ik5pwc/12v-ups/Kicad/monitoring/monitoring.kicad_pcb

## KiCad design Kicad/monitoring/monitoring.kicad_pcb (2025-08-01)

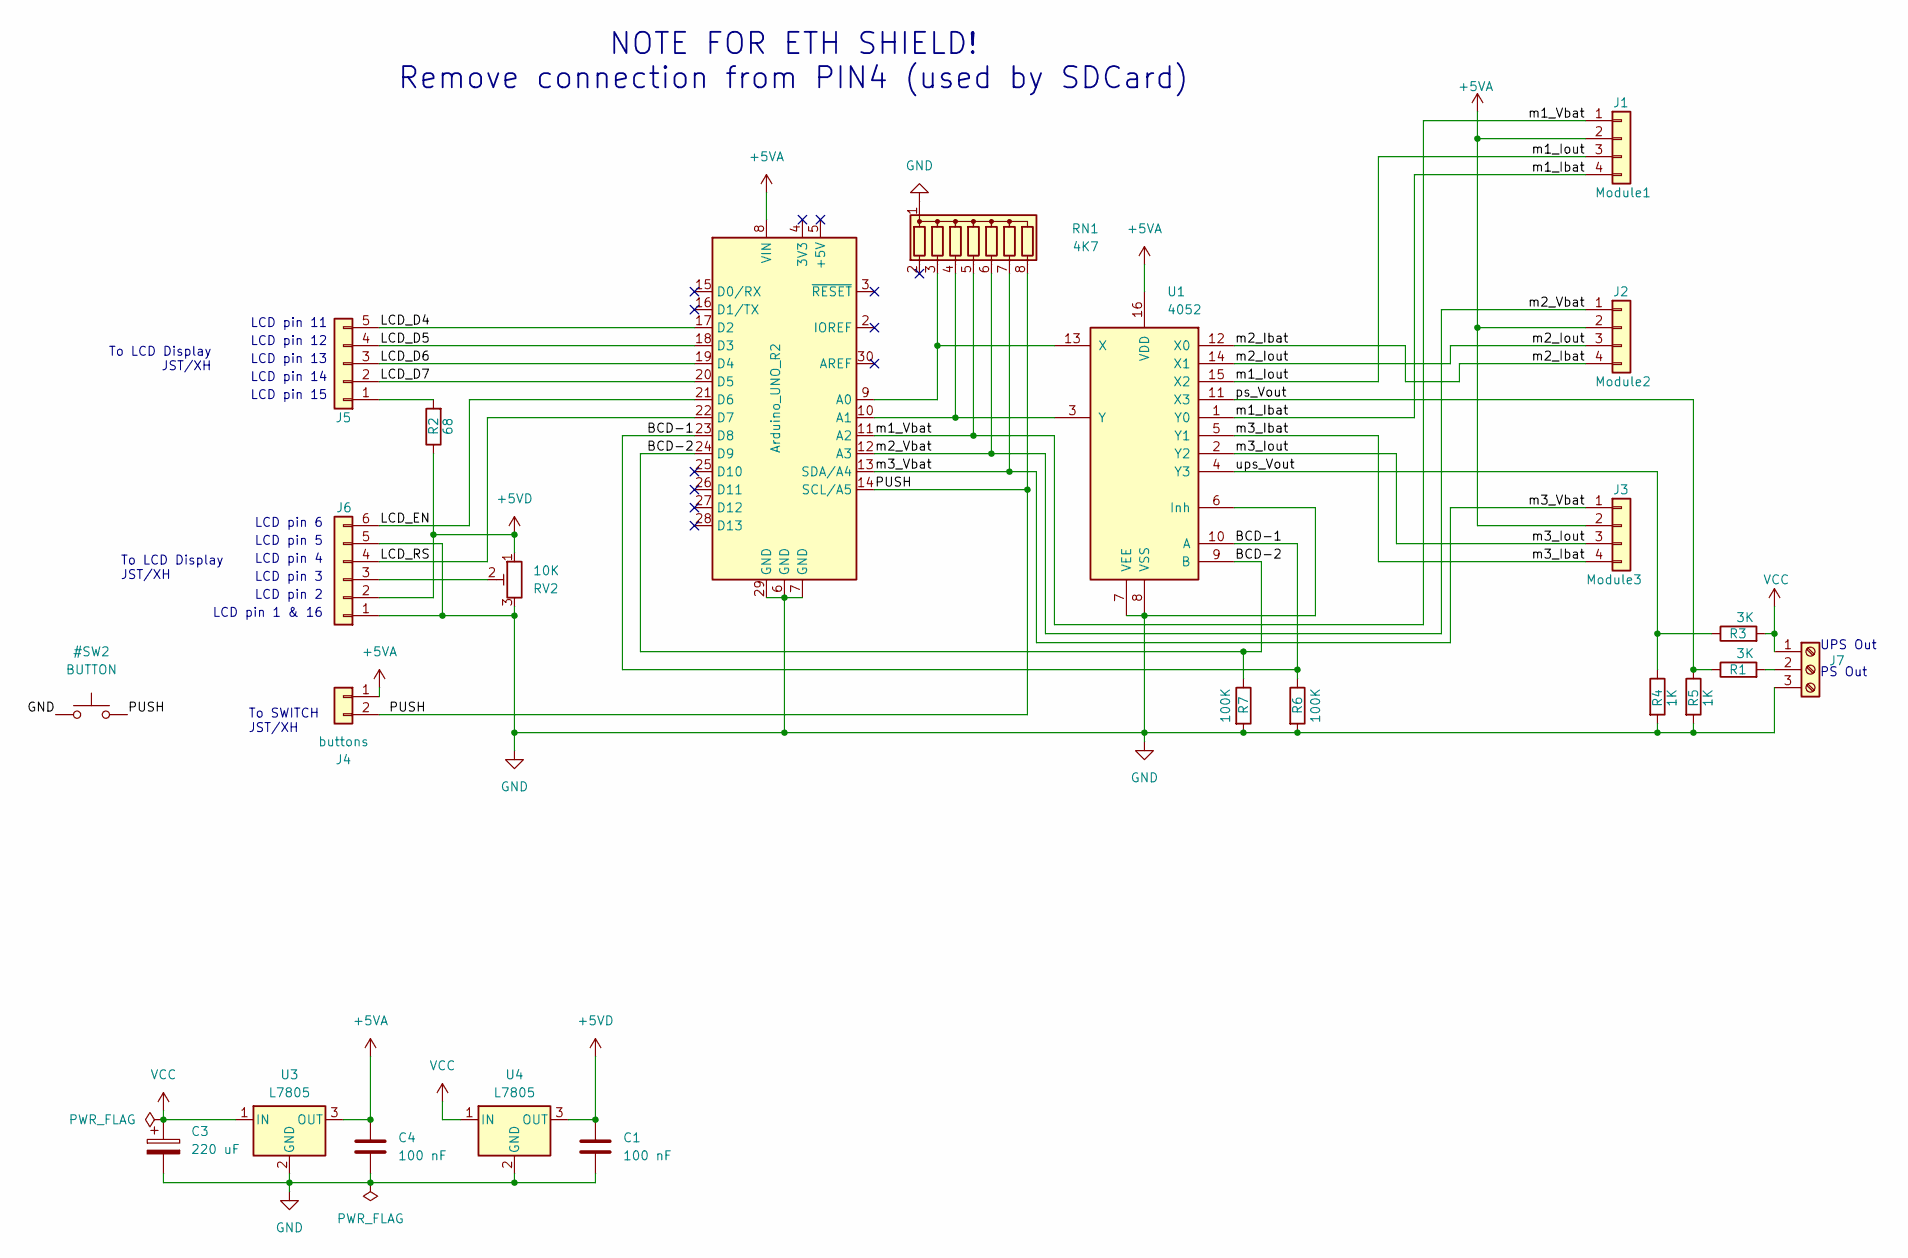
[picture p1: schematic monitoring.kicad_sch]

Parts:
A1: Arduino_UNO_R2
C1, C4: 100 nF; C_Disc_D4.7mm_W2.5mm_P5.00mm
C3: 220 uF; CP_Radial_D10.0mm_P5.00mm
J1: Module1; JST_XH_B4B-XH-A_1x04_P2.50mm_Vertical
J2: Module2; JST_XH_B4B-XH-A_1x04_P2.50mm_Vertical
J3: Module3; JST_XH_B4B-XH-A_1x04_P2.50mm_Vertical
J4: buttons; JST_XH_B2B-XH-A_1x02_P2.50mm_Vertical
J5: Display; JST_XH_B5B-XH-A_1x05_P2.50mm_Vertical
J6: Display; JST_XH_B6B-XH-A_1x06_P2.50mm_Vertical
J7: DC_in_outout; TerminalBlock_bornier-3_P5.08mm
R1, R3: 3K; R_Axial_DIN0204_L3.6mm_D1.6mm_P7.62mm_Horizontal
R2: 68; R_Axial_DIN0204_L3.6mm_D1.6mm_P7.62mm_Horizontal
R4, R5: 1K; R_Axial_DIN0204_L3.6mm_D1.6mm_P7.62mm_Horizontal
R6, R7: 100K; R_Axial_DIN0204_L3.6mm_D1.6mm_P7.62mm_Horizontal
RN1: 4K7; R_Array_SIP8
RV2: 10K; Potentiometer_Bourns_3296W_Vertical
U1: 4052; DIP-16_W7.62mm_LongPads
U3, U4: L7805; TO-220-3_Vertical

Connections:
+5VA: A1.8 (VIN), C4.1, J1.2, J2.2, J3.2, J4.1, U1.16 (VDD), U3.3 (OUT)
+5VD: C1.1, J6.2, R2.1, RV2.1, U4.3 (OUT)
/BCD-1: A1.23 (D8), R6.1, U1.10 (A)
/BCD-2: A1.24 (D9), R7.1, U1.9 (B)
/LCD_D4: A1.17 (D2), J5.5
/LCD_D5: A1.18 (D3), J5.4
/LCD_D6: A1.19 (D4), J5.3
/LCD_D7: A1.20 (D5), J5.2
/LCD_EN: A1.21 (D6), J6.6
/LCD_RS: A1.22 (D7), J6.4
/PUSH: A1.14 (SCL/A5), J4.2, RN1.8 (R7)
/m1_Ibat: J1.4, U1.1 (Y0)
/m1_Iout: J1.3, U1.15 (X2)
/m1_Vbat: A1.11 (A2), J1.1, RN1.5 (R4)
/m2_Ibat: J2.4, U1.12 (X0)
/m2_Iout: J2.3, U1.14 (X1)
/m2_Vbat: A1.12 (A3), J2.1, RN1.6 (R5)
/m3_Ibat: J3.4, U1.5 (Y1)
/m3_Iout: J3.3, U1.2 (Y2)
/m3_Vbat: A1.13 (SDA/A4), J3.1, RN1.7 (R6)
/ps_Vout: R1.1, R5.1, U1.11 (X3)
/ups_Vout: R3.1, R4.1, U1.4 (Y3)
GND: A1.6 (GND), A1.7 (GND), A1.29 (GND), C1.2, C3.2, C4.2, J6.1, J6.5, J7.3, R4.2, R5.2, R6.2, R7.2, RN1.1 (common), RV2.3, U1.6 (Inh), U1.7 (VEE), U1.8 (VSS), U3.2 (GND), U4.2 (GND)
unnamed: A1.9 (A0), RN1.3 (R2), U1.13 (X)
unnamed: A1.10 (A1), RN1.4 (R3), U1.3 (Y)
unnamed: J5.1, R2.2
unnamed: J6.3, RV2.2
unnamed: J7.2, R1.2
VCC: C3.1, J7.1, R3.2, U3.1 (IN), U4.1 (IN)

Notes on the sheet:
LCD pin 13
LCD pin 3
UPS Out
NOTE FOR ETH SHIELD! Remove connection from PIN4 (used by SDCard)
LCD pin 11
LCD pin 15
To SWITCH JST/XH
LCD pin 14
To LCD Display JST/XH
LCD pin 1 & 16
LCD pin 12
LCD pin 5
LCD pin 4
LCD pin 6
LCD pin 2
PS Out

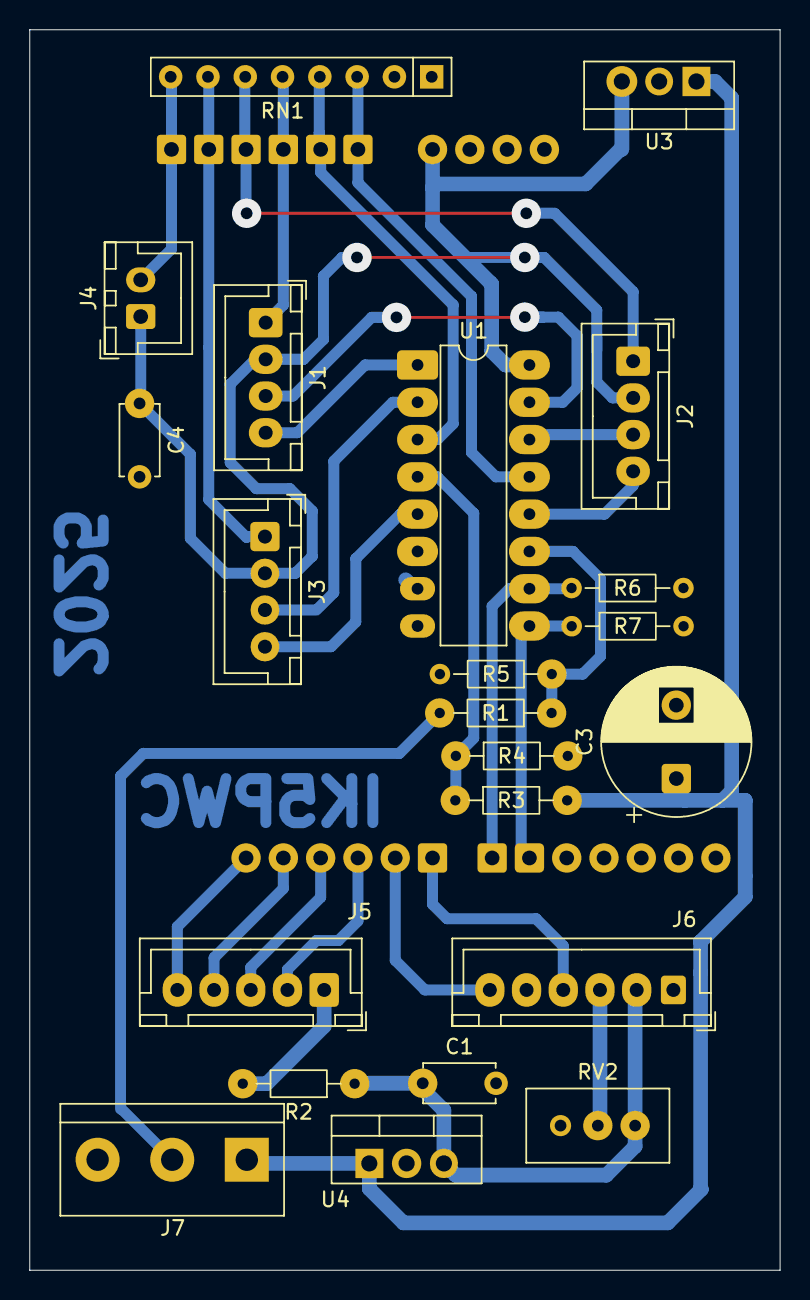
[picture p2: board monitoring.kicad_pcb from above]

Board: 2 copper layers, 51.1 x 84.5 mm, 23 parts (1 on the bottom side), 29 nets.
