ik5pwc/12v-ups/Kicad/12vUPS-modules-diodeIdeal-with-GND/12vUPS.kicad_pcb

## KiCad design Kicad/12vUPS-modules-diodeIdeal-with-GND/12vUPS.kicad_pcb (2025-06-20)

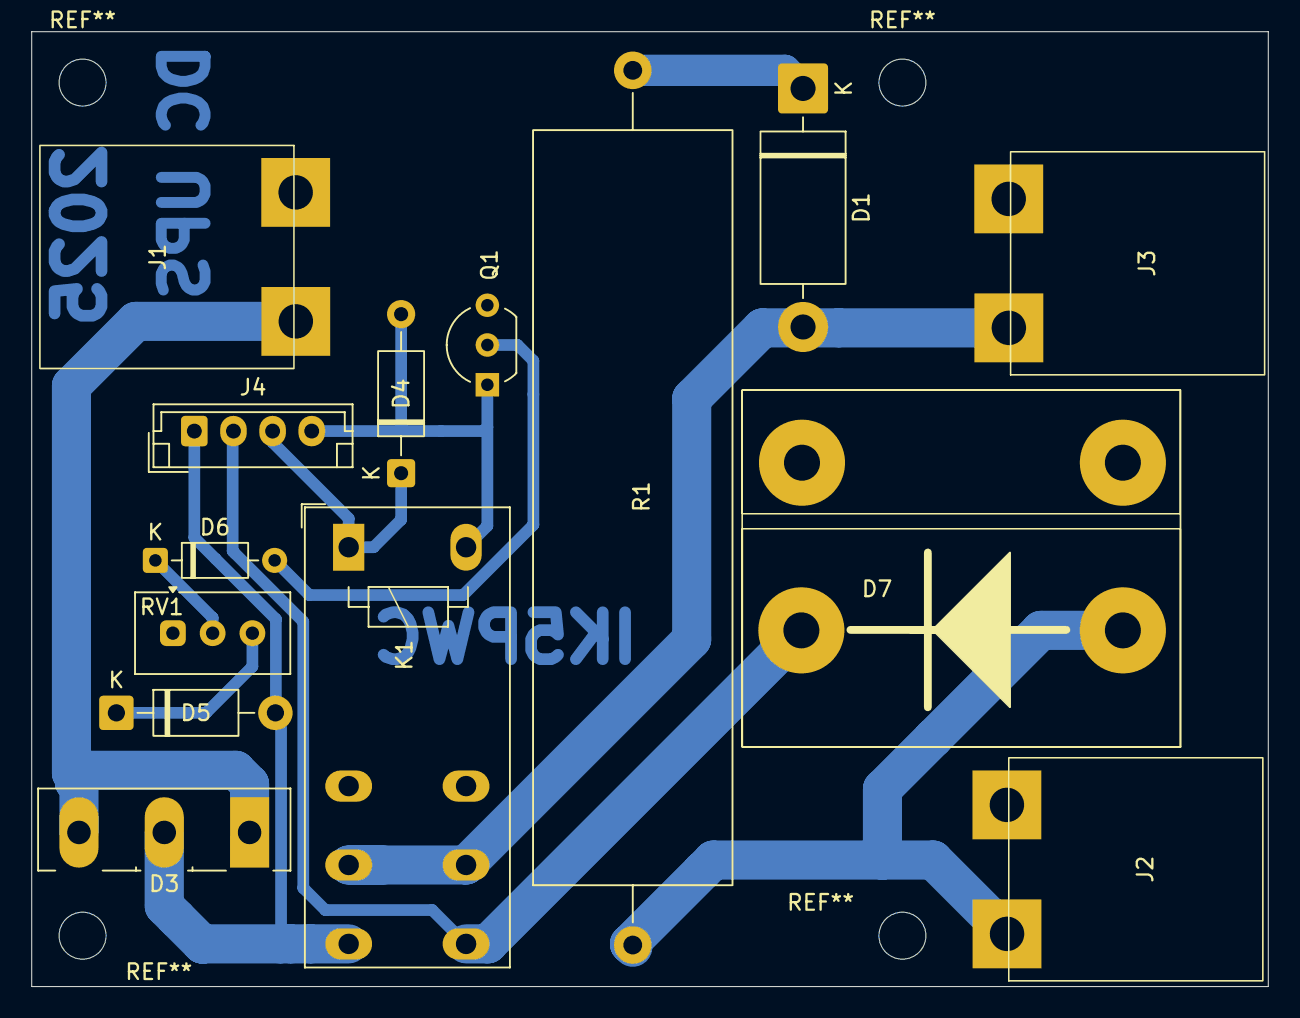
[picture p3: board 12vUPS.kicad_pcb from above]

Board: 2 copper layers, 79.0 x 61.0 mm, 14 parts (0 on the bottom side), 12 nets.

Parts:
D1: SF30GG; D_DO-201AD_P15.24mm_Horizontal
D3: 60CPQ150; TO-247-3_Vertical
D4: 1N4001; D_A-405_P10.16mm_Horizontal
D5: D; D_DO-41_SOD81_P10.16mm_Horizontal
D6: 4V1; D_DO-35_SOD27_P7.62mm_Horizontal
D7: D_Ideal; D_IDEAL_with_GND
J1: INPUT; Mammooth_4mm
J2: BATTERY; Mammooth_4mm
J3: OUTPUT; Mammooth_4mm
J4: ENABLE; JST_EH_B4B-EH-A_1x04_P2.50mm_Vertical
K1: VEGHA L08A0212VDC; VEGhA L08 12V dc
Q1: BC337; TO-92_Inline_Wide
R1: 2R7; R_Axial_Power_L48.0mm_W12.5mm_P55.88mm
RV1: 10K; Potentiometer_Vishay_T93YA_Vertical

Connections:
/BATT_IN: D7.2 (A), J2.1, R1.1
/BJT-GND: D4.2 (A), J4.4, K1.A2, Q1.1 (C)
/DC-IN-RELE: D3.2 (K), D5.2 (A), J4.1, K1.14
/DC_IN: D3.1 (A), D3.3 (A), J1.2
/ENA: D4.1 (K), J4.3, K1.A1
/OUT: D1.2 (A), J3.1, K1.11, K1.21
GND: D7.3 (GND), J1.1, J2.2, J3.2, Q1.3 (E), RV1.1
unnamed: D1.1 (K), R1.2
unnamed: D5.1 (K), RV1.3
unnamed: D6.2 (A), Q1.2 (B)
unnamed: D6.1 (K), RV1.2
unnamed: D7.1 (K), J4.2, K1.24
