ik5pwc/12v-ups/Kicad/SensorBoard/SensorBoard.kicad_pcb

## KiCad design Kicad/SensorBoard/SensorBoard.kicad_pcb (2025-07-25)

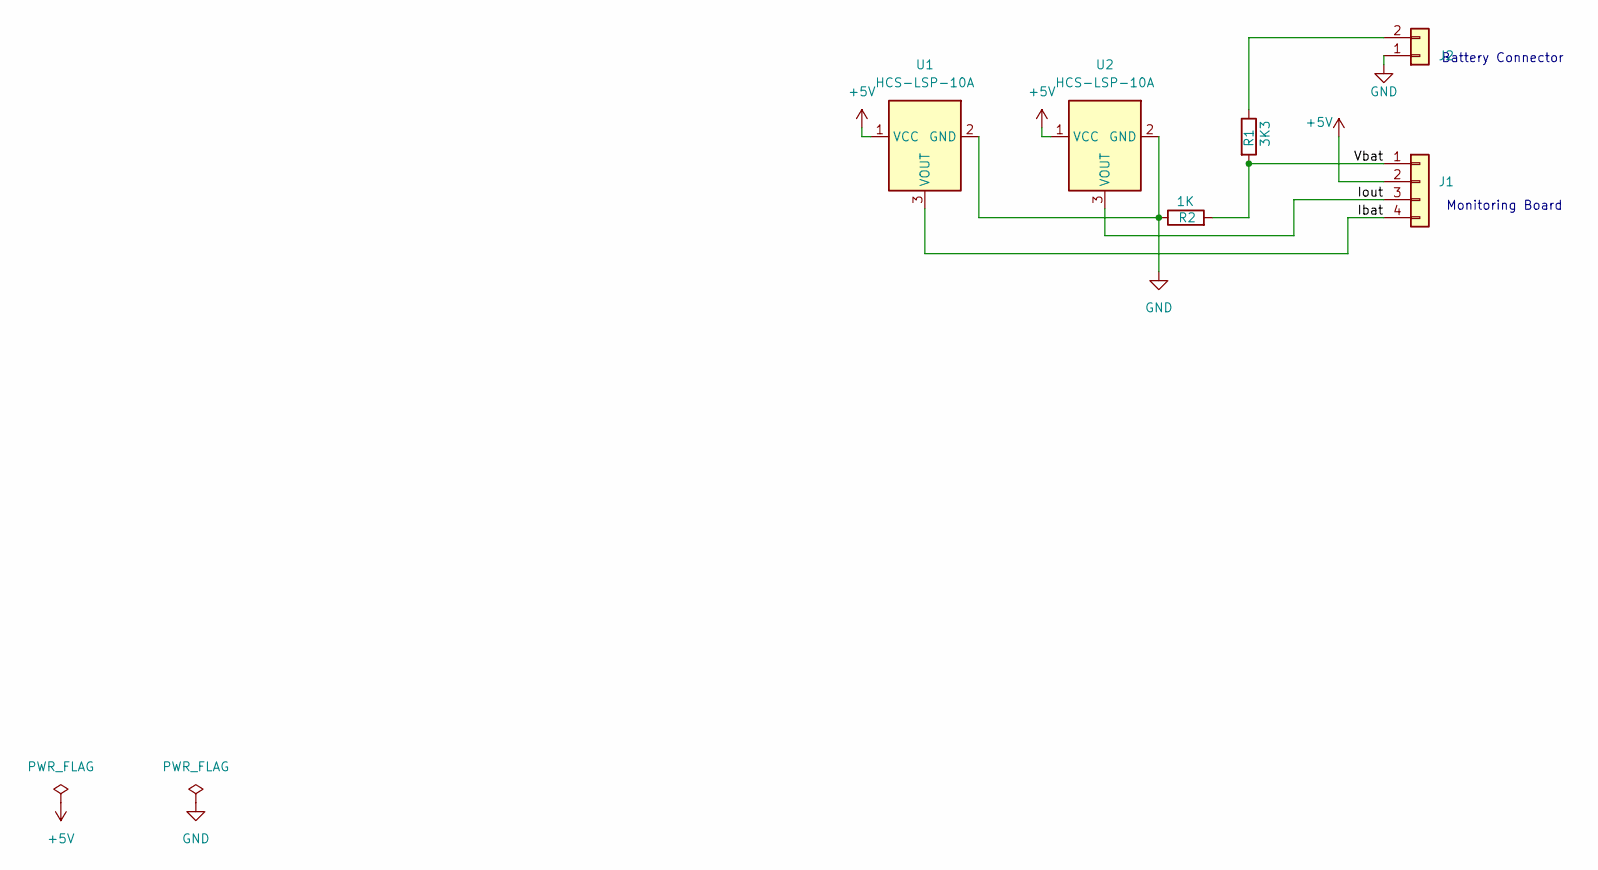
[picture p4: schematic SensorBoard.kicad_sch]

Parts:
J1: Conn_01x04; JST_XH_B4B-XH-A_1x04_P2.50mm_Vertical
J2: Conn_01x02; Mammooth_4mm
R1: 3K3; R_Axial_DIN0204_L3.6mm_D1.6mm_P7.62mm_Horizontal
R2: 1K; R_Axial_DIN0204_L3.6mm_D1.6mm_P7.62mm_Horizontal
U1, U2: HCS-LSP-10A; HCS-LSP

Connections:
+5V: J1.2, U1.1 (VCC), U2.1 (VCC)
/Ibat: J1.4, U1.3 (VOUT)
/Iout: J1.3, U2.3 (VOUT)
/Vbat: J1.1, R1.2, R2.2
GND: J2.1, R2.1, U1.2 (GND), U2.2 (GND)
unnamed: J2.2, R1.1

Notes on the sheet:
Monitoring Board
Battery Connector

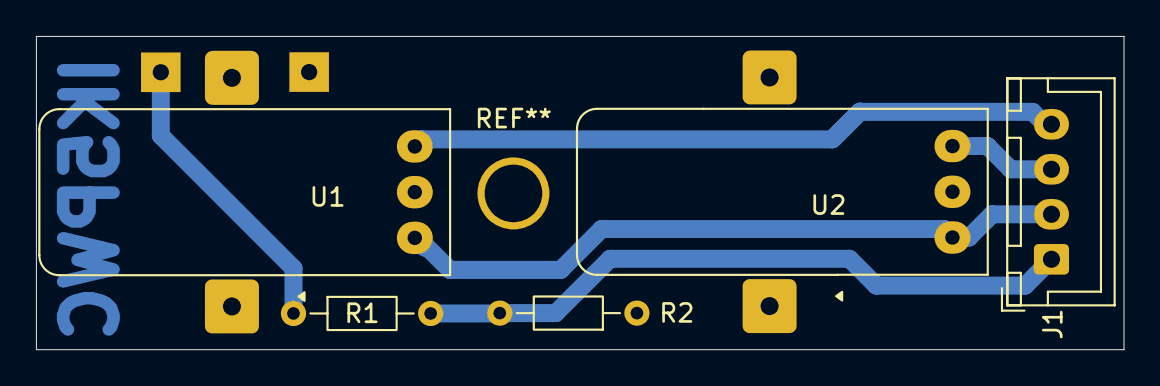
[picture p5: board SensorBoard.kicad_pcb from above]

Board: 2 copper layers, 60.4 x 17.4 mm, 6 parts (0 on the bottom side), 6 nets.
