ik5pwc/12v-ups/(commit log)

2025-06-02 Update 12vUPS-2025-06-02_174418.zip, 12vUPS-2025-06-02_175555.zip, 12vUPS-2025-06-02_180136.zip, and 8 more files
    [12vUPS.kicad_pcb, 12vUPS.kicad_sch]
2025-06-06 Update 12vUPS-2025-06-02_174418.zip, 12vUPS-2025-06-06_223532.zip, 12vUPS-2025-06-06_224038.zip, and 9 more files
    [12vUPS.kicad_pcb, 12vUPS.kicad_sch]
2025-06-07 Update #auto_saved_files#, 12vUPS-2025-06-06_223532.zip, 12vUPS-2025-06-07_150941.zip, and 13 more files
    [12vUPS.kicad_pcb]
2025-06-08 Update #auto_saved_files#, 12vUPS-2025-06-07_150941.zip, 12vUPS-2025-06-07_151452.zip, and 15 more files
    [12vUPS.kicad_sch]
2025-06-10 Update 12vUPS-2025-06-08_110639.zip, 12vUPS-2025-06-08_231957.zip, 12vUPS-2025-06-08_232518.zip, and 11 more files
    [12vUPS.kicad_pcb, 12vUPS.kicad_sch]
2025-06-10 Update 12vUPS-2025-06-10_185612.zip, 12vUPS-2025-06-10_190121.zip, 12vUPS-2025-06-10_190645.zip, and 3 more files
    [12vUPS.kicad_pcb, 12vUPS.kicad_sch]
2025-06-13 Update #auto_saved_files#, 12vUPS-2025-06-02_175555.zip, 12vUPS-2025-06-02_180136.zip, and 18 more files
    [12vUPS.kicad_pcb]
2025-06-20 Update 12vUPS-2025-06-06_224542.zip, 12vUPS-2025-06-06_225111.zip, 12vUPS-2025-06-06_225614.zip, and 28 more files
    [12vUPS.kicad_pcb, 12vUPS.kicad_sch]
2025-06-20 Update #auto_saved_files#, 12vUPS.kicad_prl, _autosave-12vUPS.kicad_sch, and 2 more files
2025-06-22 Update .~lock.12vUPS.csv#, 12vUPS-2025-06-08_232518.zip, 12vUPS-2025-06-08_233102.zip, and 4 more files
    [12vUPS.csv]
2025-06-22 Update 12vUPS-2025-06-08_233608.zip, 12vUPS-2025-06-08_234122.zip, 12vUPS-2025-06-22_122202.zip, and 5 more files
    [12vUPS.kicad_pcb, 12vUPS.kicad_sch]
2025-06-27 Update .~lock.12vUPS.csv#, 12vUPS-2025-06-10_185612.zip, 12vUPS-2025-06-10_190121.zip, and 11 more files
    [12vUPS.kicad_pcb]
2025-07-13 Update 12vUPS.kicad_pro, 12vUPS.kicad_sch, Sensor.kicad_sch, and 2 more files
2025-07-14 Update 12vUPS-modles.kicad_prl, 12vUPS-modules-2025-07-13_234921.zip, 12vUPS-modules-2025-07-14_221001.zip, and 54 more files
    [12vUPS-modules.kicad_pcb, 12vUPS-modules.kicad_sch, 12vUPS.csv, Sensor.kicad_sch, monitoring.kicad_pcb, monitoring.kicad_sch]
2025-07-17 Update 12vUPS-modles.kicad_prl, 12vUPS-modules-2025-07-13_234921.zip, 12vUPS-modules-2025-07-14_221001.zip, and 69 more files
    [12vUPS-modules.kicad_pcb, 12vUPS-modules.kicad_sch, Sensor.kicad_sch, SensorBoard.kicad_pcb, SensorBoard.kicad_sch, monitoring.kicad_pcb, monitoring.kicad_sch]
2025-07-17 Update #auto_saved_files#, Arduino_UNO_R2.kicad_mod, fp-info-cache, and 9 more files
    [monitoring.kicad_pcb, monitoring.kicad_sch]
2025-07-17 Ready for 1st test
    [monitoring.kicad_pcb, monitoring.kicad_sch]
2025-07-17 Update #auto_saved_files# and ~monitoring.kicad_sch.lck
2025-07-22 Update .cproject, .project, UPSMonitor.ino, and 29 more files
    [SensorBoard.kicad_pcb, SensorBoard.kicad_sch, monitoring.kicad_pcb]
2025-07-22 Update UPSMonitor.ino, datatypes.h, io.cpp, and 18 more files
    [monitoring.kicad_pcb, monitoring.kicad_sch]
2025-07-25 Update .sproject, io.cpp, io.h, and 29 more files
    [Calcolo partitori.xlsx, SensorBoard.kicad_pcb, monitoring.csv, monitoring.kicad_pcb, monitoring.kicad_sch]
2025-07-25 Update monitoring.kicad_pro and ~monitoring.kicad_sch.lck
2025-07-25 Update 12vUPS-2025-07-25_155804.zip, #auto_saved_files#, 12vUPS-2025-06-08_233102.zip, and 32 more files
    [12vUPS.kicad_pcb, 12vUPS.kicad_sch]
2025-08-01 Update .sproject, params.h, SensorBoard-2025-07-29_231028.zip, and 10 more files
    [monitoring.kicad_pcb]
2025-08-01 Update fp-info-cache, monitoring-2025-07-18_201733.zip, monitoring-2025-07-18_212227.zip, and 5 more files
    [monitoring.kicad_pcb, monitoring.kicad_sch]
